hebeieh/autonomous_chess/docs/components_list.csv

Название компонента | Количетсво | Описание
Raspberry Pi Zero 2W | 1 | Микроконтроллер для управления логикой работы
NEMA 17 HS4023 | 2 | Шаговые моторы для движение электромагнита
DRV 8825 | 2 | Драйверы шаговых моторов
Motor Driver Shield | 2 | Плата расширения для подключения моторов и их драйверов
Ведущие шкивы GT2 20Т | 2 | Шкивы крепящиеся к шаговым моторам и ремням gt2
Натяжители зубчатые GT2 20Т | 6 | Детали для натяжения ремня gt2
Натяжители гладкие GT2 | 2 | Детали для натяжения ремня gt2
Ремень GT2 | 2 | Ремень
Электромагнит | 1 | Электромагнит
Линейный подшипник SCS8UU | 4 | Подшипники для движения деталей по стальным стержням с минимальным трением
Стальные стержни 8*500мм | 4 | Стальные стержни
MCP23017 | 1 | Плата расширения I2C
Геркон | 64 | Датчики холла для детекции магнитов
Транзистор IRLZ44N | 1 | Транзистор для управление электромагнитом
Резистор 220Ом | 1 | Резистор
Резистор 1кОм | 1 | Резистор
Неодимовые магниты | 32 | Магниты для крепления под шахматные фигуры
Фиксаторы моторов, стержней и натяжителей |  | Смоделированные и напечатанные на 3д принтере детали
Корпус из дерева | 1 | Вырезанный лазеров из фанеры 6мм корпус
