hebeieh/autonomous_chess/CAD/Сборка_доски_2ver.SLDASM

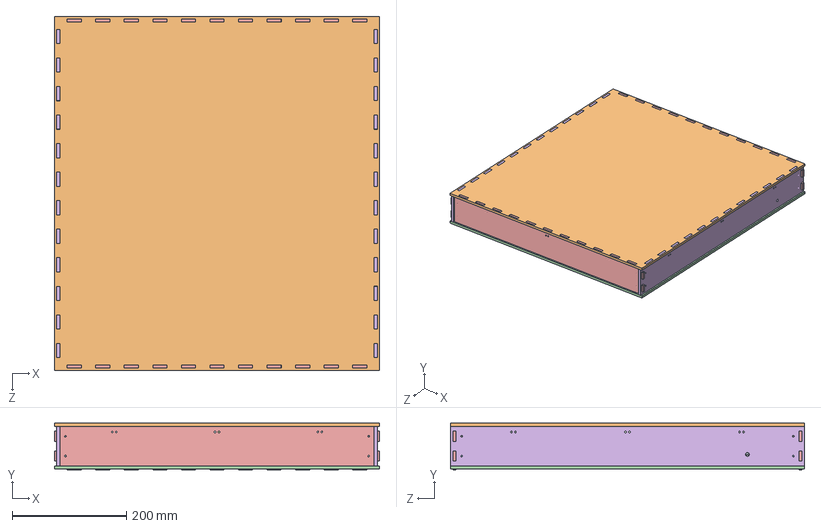
[picture p1: CAD file, 2026-11-10]
CAD/Сборка_доски_2ver.SLDASM
570.1 x 81.7 x 620.0 mm
nema17 x 2
nema17_mount x 2
стержень_8-500 x 4
Натяжитель x 8
Поддержка_натяжителей x 2
Крепление_натяжителей_правое
Крепление_натяжителей_левое
Нижняя_доска
SCS8UU x 4
Коннектор_электрмагнита
Крепление_боковое_левое
Крепление_боковое_правое
Электромагнит
Стена_перед x 2
Стена_бок x 2
Уголок x 8
Уголок_x2 x 12
Верхняя_доска
поддержка_магнита
