hebeieh/autonomous_chess/CAD/На печать/Крепление_боковое_левое.STL

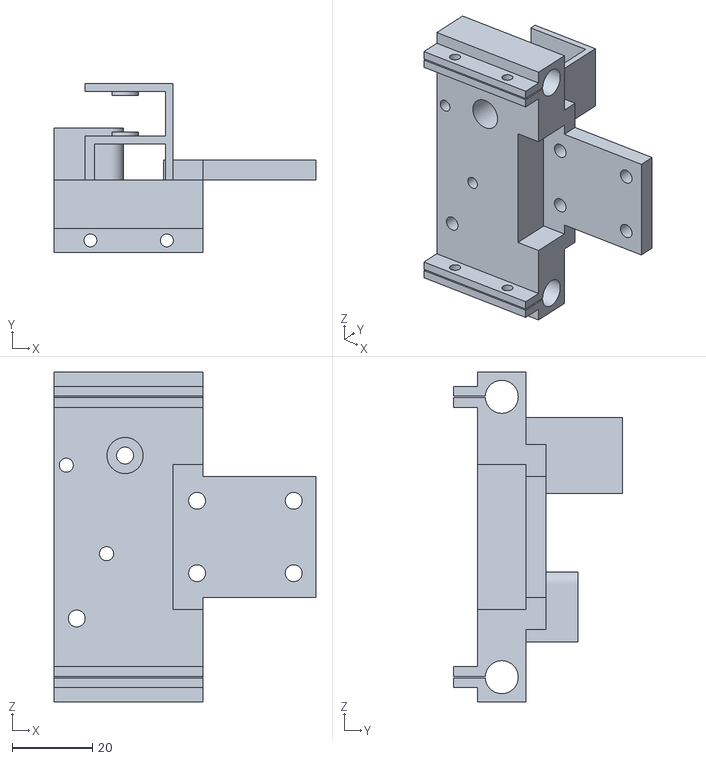
[picture p2: CAD file, 2026-11-10]
CAD/На печать/Крепление_боковое_левое.STL
65.0 x 42.0 x 82.0
