hebeieh/autonomous_chess/CAD/резка/дырка2.dxf

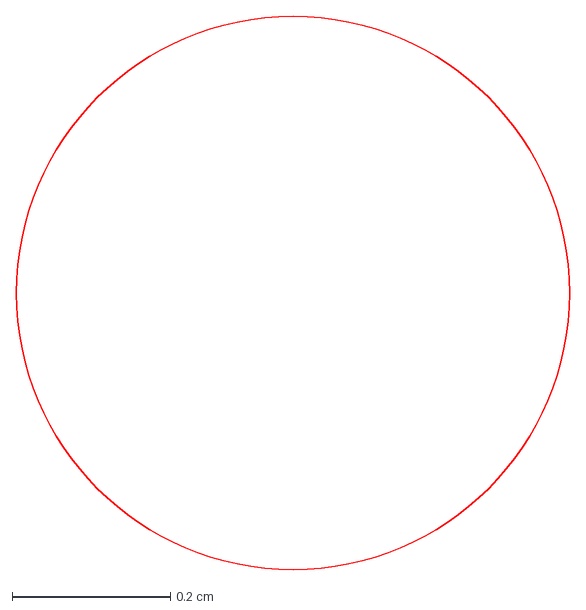
[picture p3: CAD file, 2026-11-10]
CAD/резка/дырка2.dxf
0.7 x 0.7 cm
