hebeieh/autonomous_chess/CAD/Уголок.SLDPRT

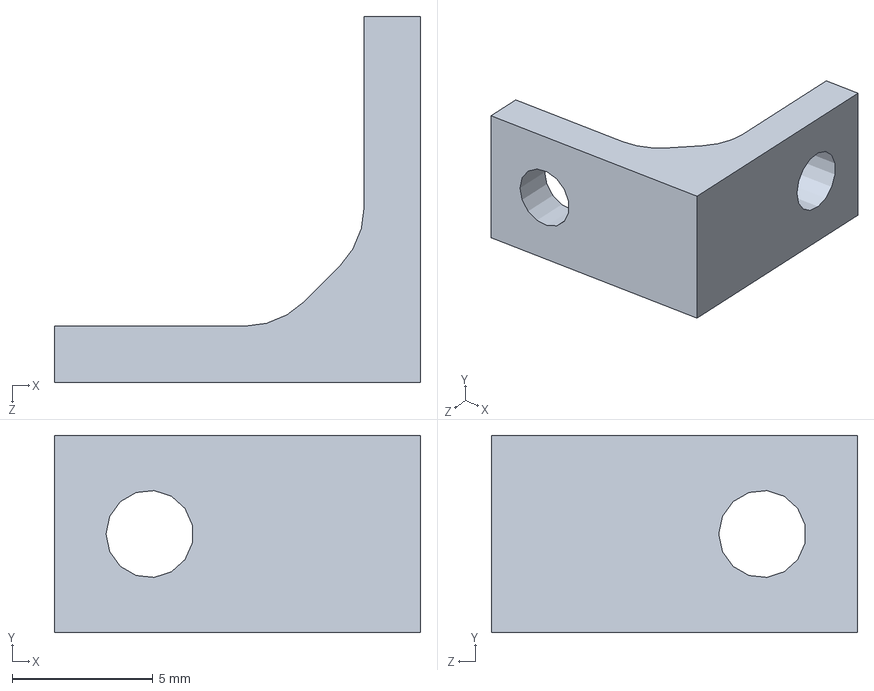
[picture p4: CAD file, 2026-11-10]
CAD/Уголок.SLDPRT
13.0 x 7.00 x 13.0 mm
