hebeieh/autonomous_chess/CAD/Крепление_натяжителей_левое.SLDPRT

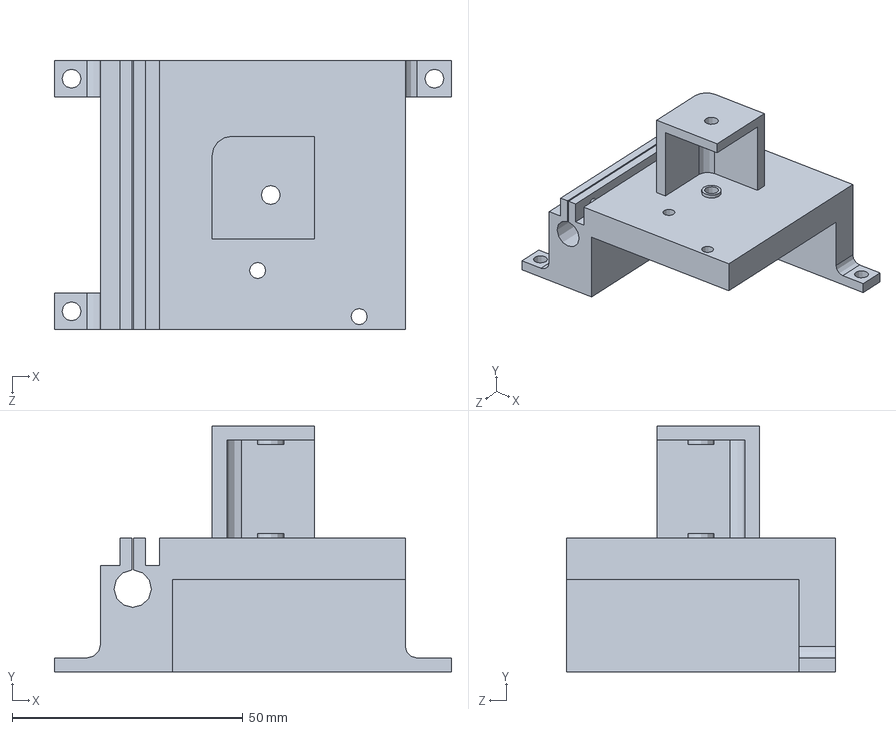
[picture p5: CAD file, 2026-11-10]
CAD/Крепление_натяжителей_левое.SLDPRT
86.0 x 53.2 x 58.3 mm
