hebeieh/autonomous_chess/CAD/На печать/Уголок_x2.STL

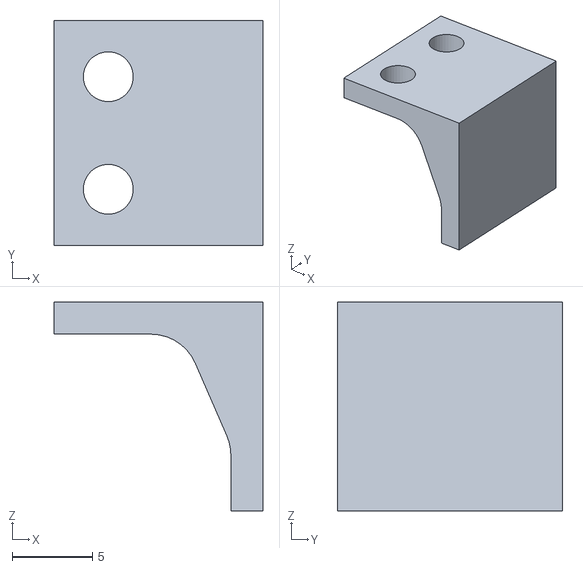
[picture p6: CAD file, 2026-11-10]
CAD/На печать/Уголок_x2.STL
13.0 x 14.0 x 13.0
