hebeieh/autonomous_chess/CAD/резка/поддержка_магнита.DXF

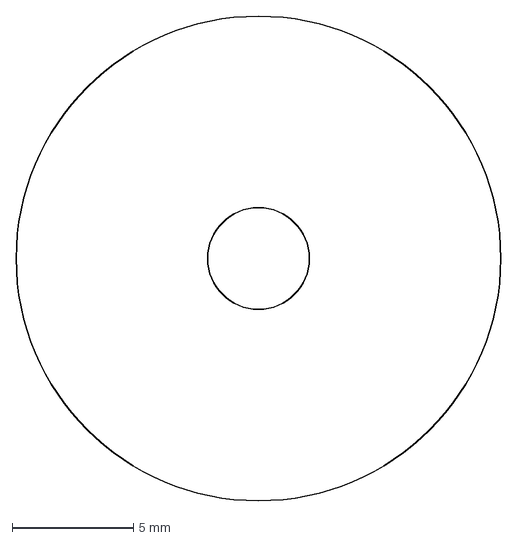
[picture p7: CAD file, 2026-11-10]
CAD/резка/поддержка_магнита.DXF
20.0 x 20.0 mm
