hebeieh/autonomous_chess/CAD/Крепление_боковое_правое.SLDPRT

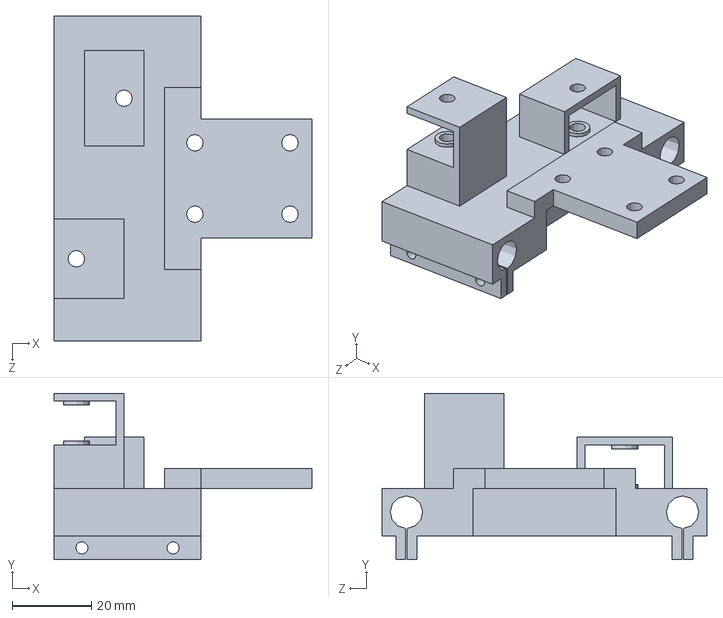
[picture p8: CAD file, 2026-11-10]
CAD/Крепление_боковое_правое.SLDPRT
65.0 x 42.0 x 82.0 mm
