hebeieh/autonomous_chess/CAD/На печать/Крепление_натяжителей_правое.STL

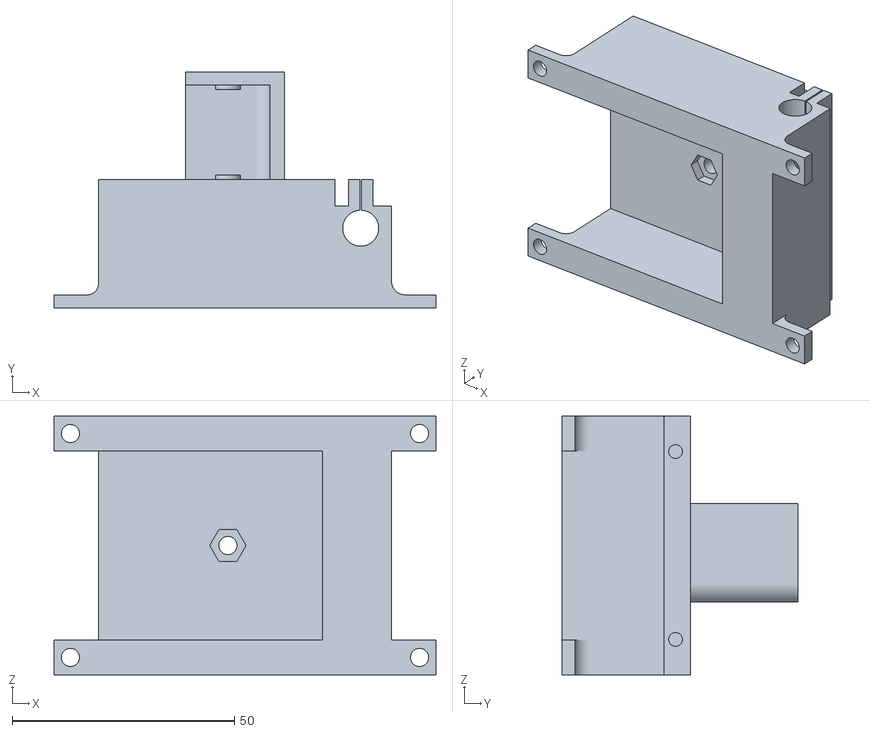
[picture p9: CAD file, 2026-11-10]
CAD/На печать/Крепление_натяжителей_правое.STL
86.0 x 53.2 x 58.3
