hebeieh/autonomous_chess/CAD/Коннектор_электрмагнита.SLDPRT

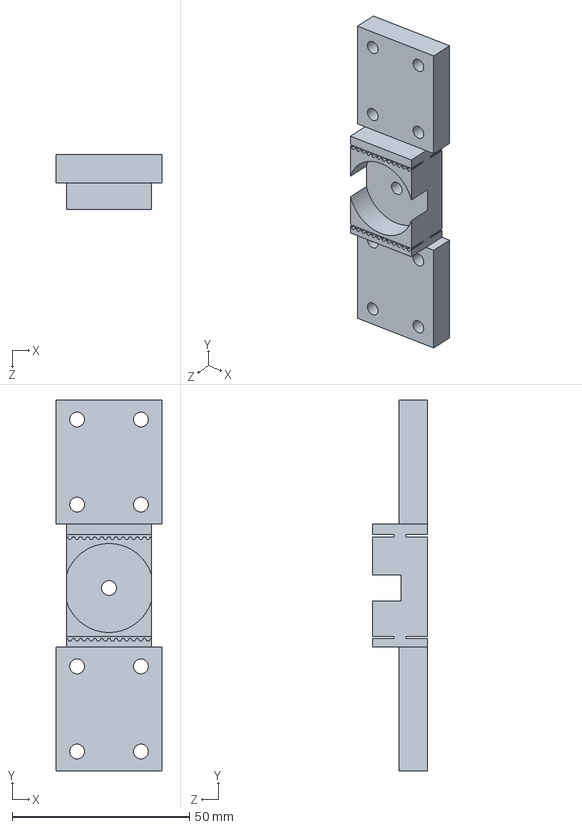
[picture p10: CAD file, 2026-11-10]
CAD/Коннектор_электрмагнита.SLDPRT
30.0 x 104.7 x 15.4 mm
