hebeieh/autonomous_chess/CAD/резка/Стена_перед.DXF

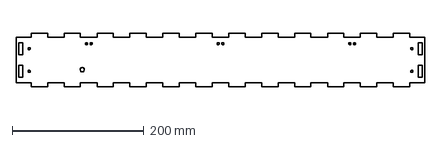
[picture p11: CAD file, 2026-11-10]
CAD/резка/Стена_перед.DXF
620.0 x 80.6 mm
