hebeieh/autonomous_chess/CAD/На печать/Ножки.STL

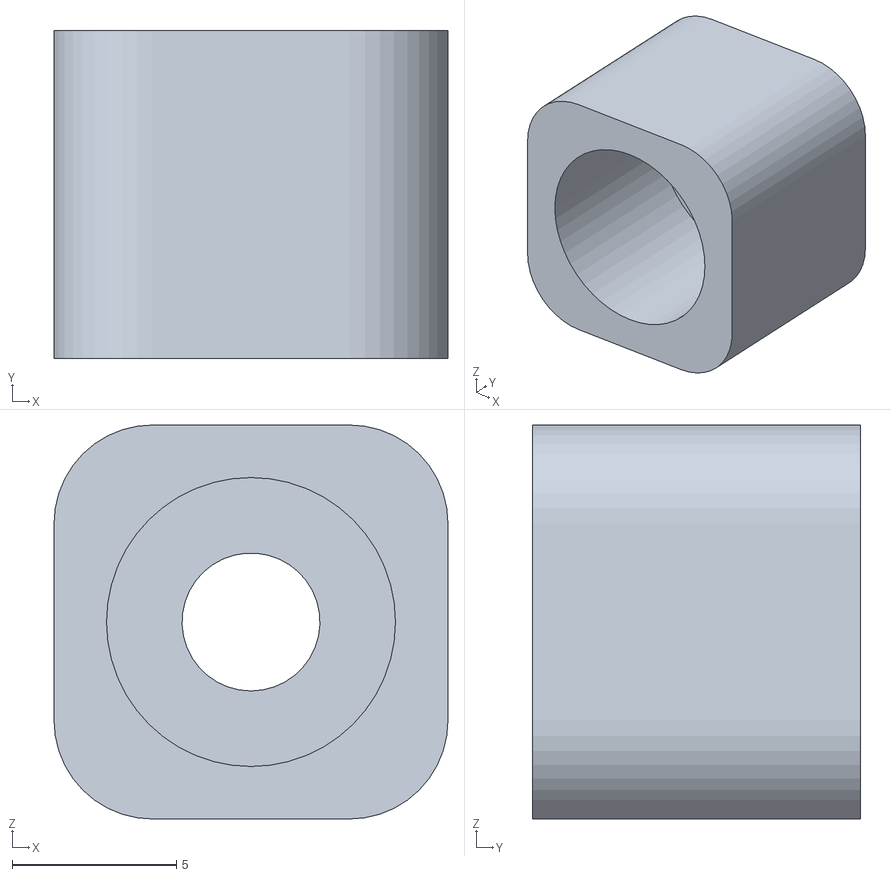
[picture p12: CAD file, 2026-11-10]
CAD/На печать/Ножки.STL
12.0 x 10.0 x 12.0
