hebeieh/autonomous_chess/CAD/резка/Стена_бок.DXF

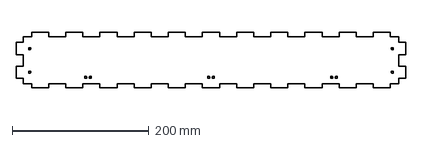
[picture p13: CAD file, 2026-11-10]
CAD/резка/Стена_бок.DXF
570.0 x 81.7 mm
