hebeieh/autonomous_chess/CAD/На печать/поддержка_магнита.STL

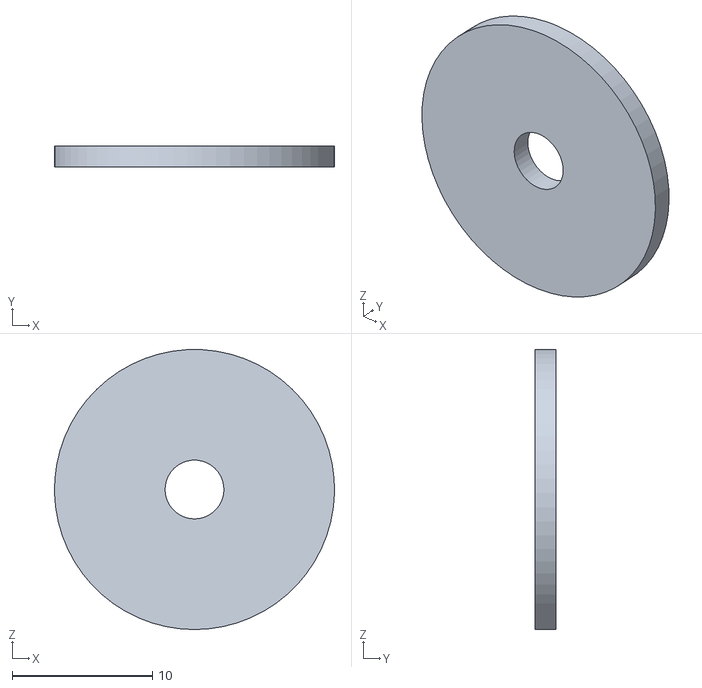
[picture p14: CAD file, 2026-11-10]
CAD/На печать/поддержка_магнита.STL
20.0 x 1.50 x 20.0
