hebeieh/autonomous_chess/CAD/резка/Нижняя_доска.DXF

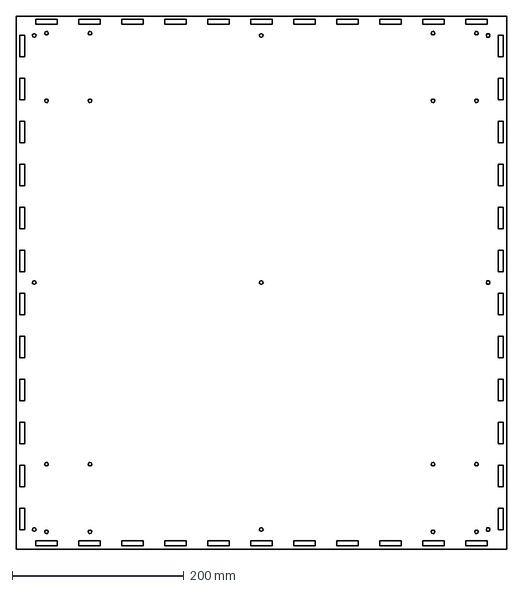
[picture p15: CAD file, 2026-11-10]
CAD/резка/Нижняя_доска.DXF
570.0 x 620.0 mm
