hebeieh/autonomous_chess/CAD/стержень_8-500.SLDPRT

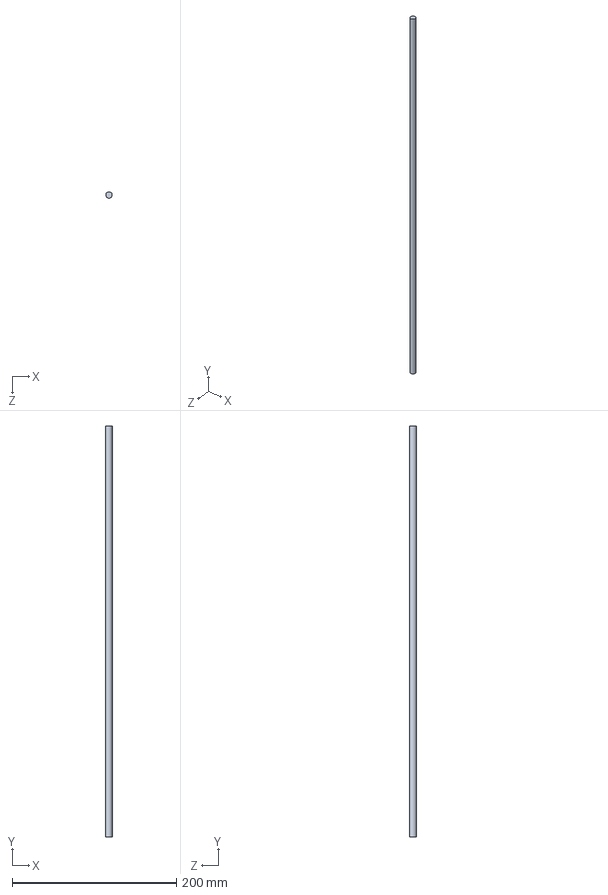
[picture p16: CAD file, 2026-11-10]
CAD/стержень_8-500.SLDPRT
7.94 x 500.0 x 8.00 mm
