hebeieh/autonomous_chess/CAD/На печать/Уголок.STL

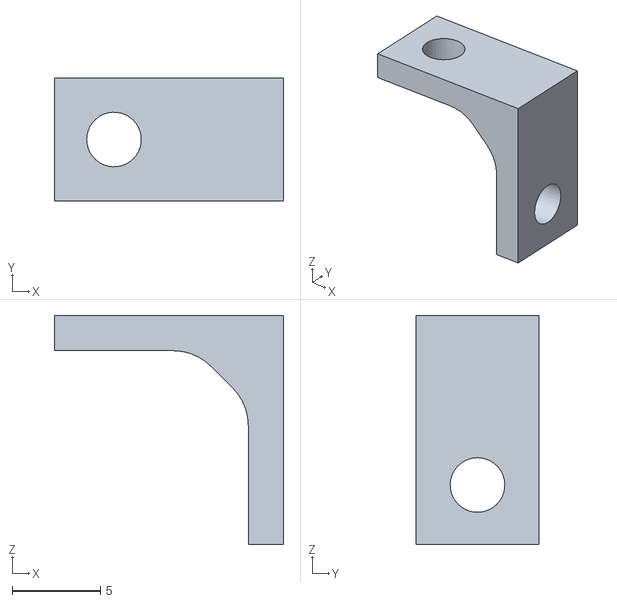
[picture p17: CAD file, 2026-11-10]
CAD/На печать/Уголок.STL
13.0 x 7.00 x 13.0
