hebeieh/autonomous_chess/CAD/На печать/Поддержка_натяжителей.STL

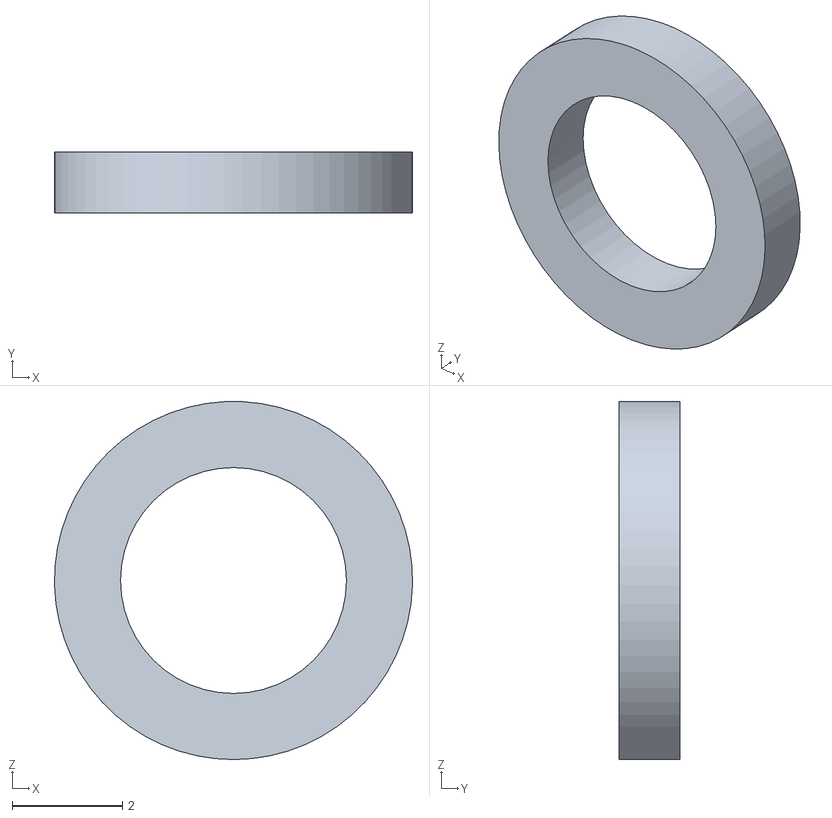
[picture p18: CAD file, 2026-11-10]
CAD/На печать/Поддержка_натяжителей.STL
6.50 x 1.10 x 6.50
