hebeieh/autonomous_chess/CAD/Стена_перед.SLDPRT

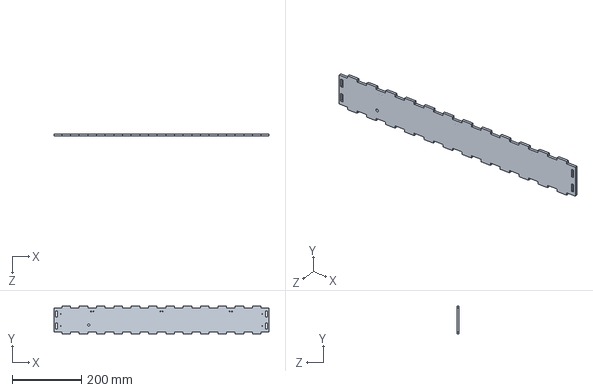
[picture p19: CAD file, 2026-11-10]
CAD/Стена_перед.SLDPRT
620.0 x 80.6 x 5.80 mm
