hebeieh/autonomous_chess/CAD/На печать/nema17_mount.STL

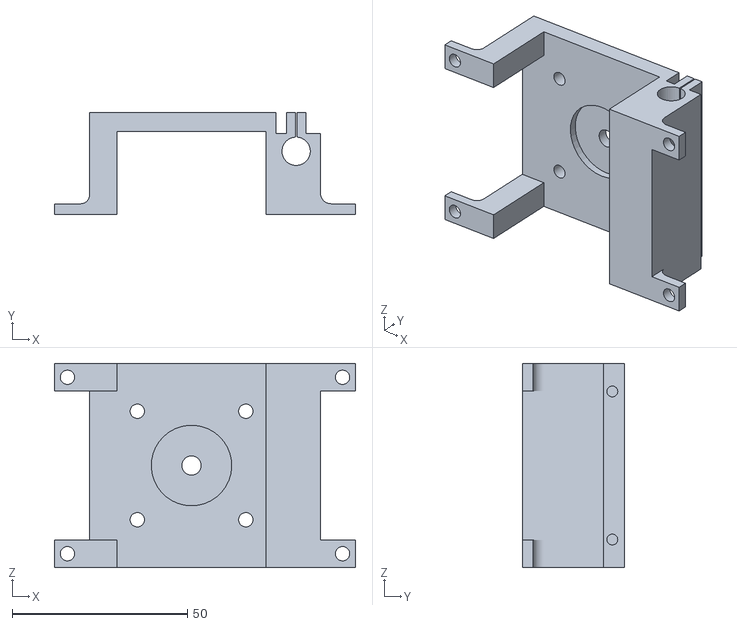
[picture p20: CAD file, 2026-11-10]
CAD/На печать/nema17_mount.STL
86.0 x 29.0 x 58.3
