hebeieh/autonomous_chess/CAD/Электромагнит.SLDPRT

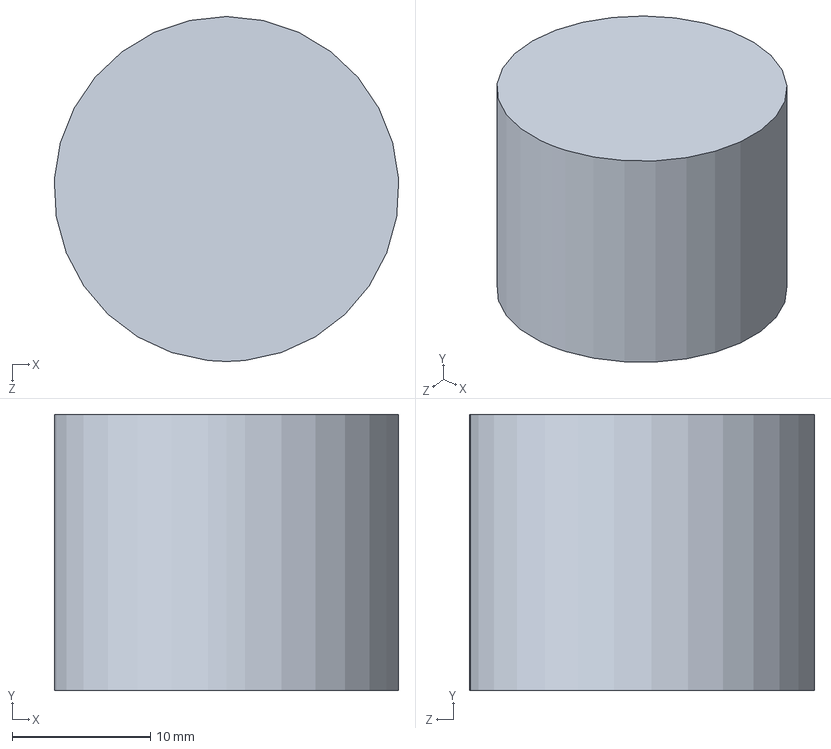
[picture p21: CAD file, 2026-11-10]
CAD/Электромагнит.SLDPRT
25.0 x 20.0 x 25.0 mm
