hebeieh/autonomous_chess/CAD/Нижняя_доска.SLDPRT

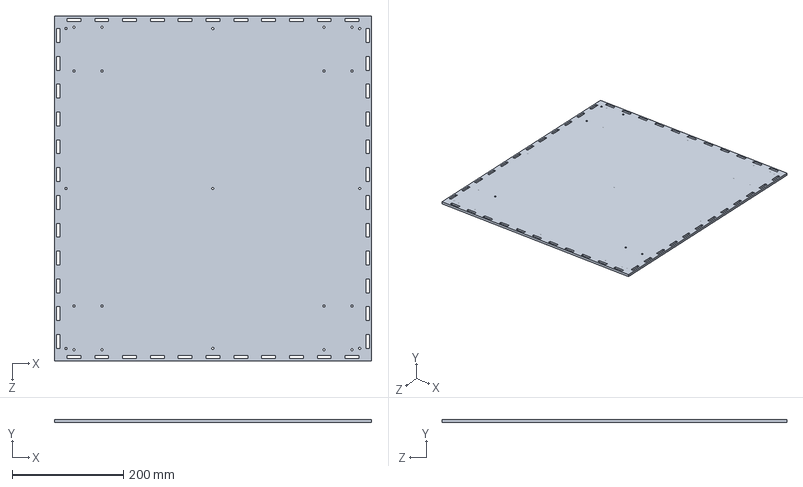
[picture p22: CAD file, 2026-11-10]
CAD/Нижняя_доска.SLDPRT
570.0 x 5.80 x 620.0 mm
