hebeieh/autonomous_chess/CAD/nema17.SLDPRT

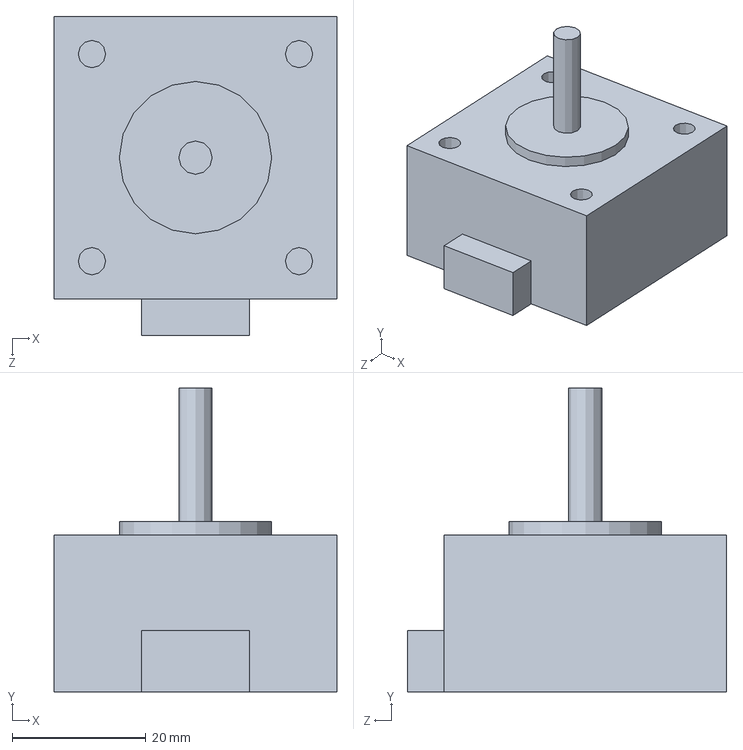
[picture p23: CAD file, 2026-11-10]
CAD/nema17.SLDPRT
42.3 x 45.5 x 47.8 mm
