hebeieh/autonomous_chess/CAD/Поддержка_натяжителей.SLDPRT

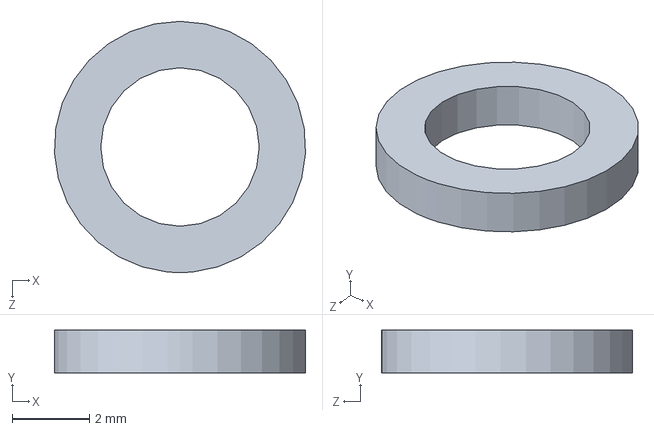
[picture p24: CAD file, 2026-11-10]
CAD/Поддержка_натяжителей.SLDPRT
6.49 x 1.10 x 6.50 mm
