hebeieh/autonomous_chess/CAD/SCS8UU.SLDPRT

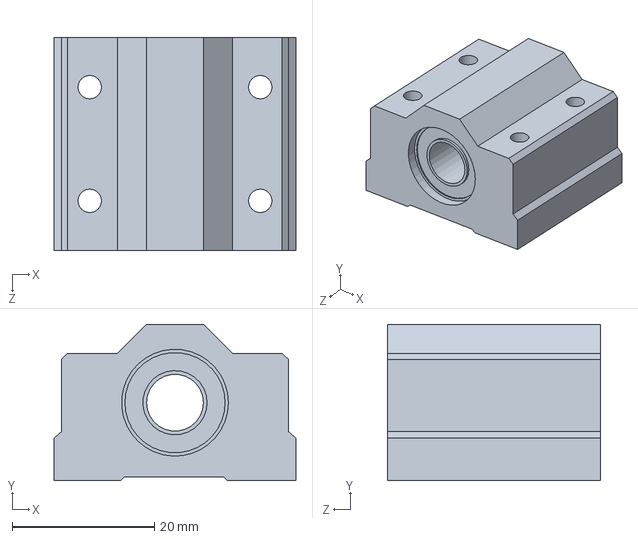
[picture p25: CAD file, 2026-11-10]
CAD/SCS8UU.SLDPRT
34.1 x 22.0 x 30.0 mm
