hebeieh/autonomous_chess/CAD/Стена_бок.SLDPRT

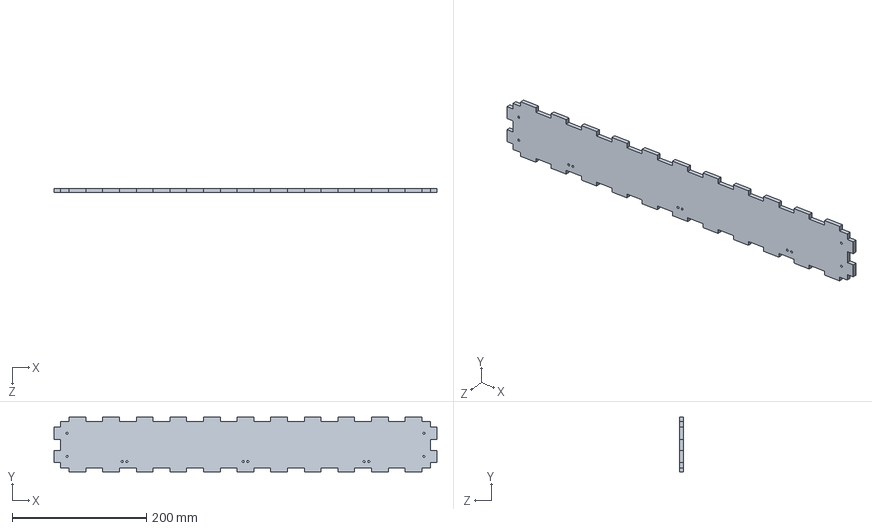
[picture p26: CAD file, 2026-11-10]
CAD/Стена_бок.SLDPRT
570.0 x 81.7 x 5.80 mm
