hebeieh/autonomous_chess/CAD/Натяжитель.SLDPRT

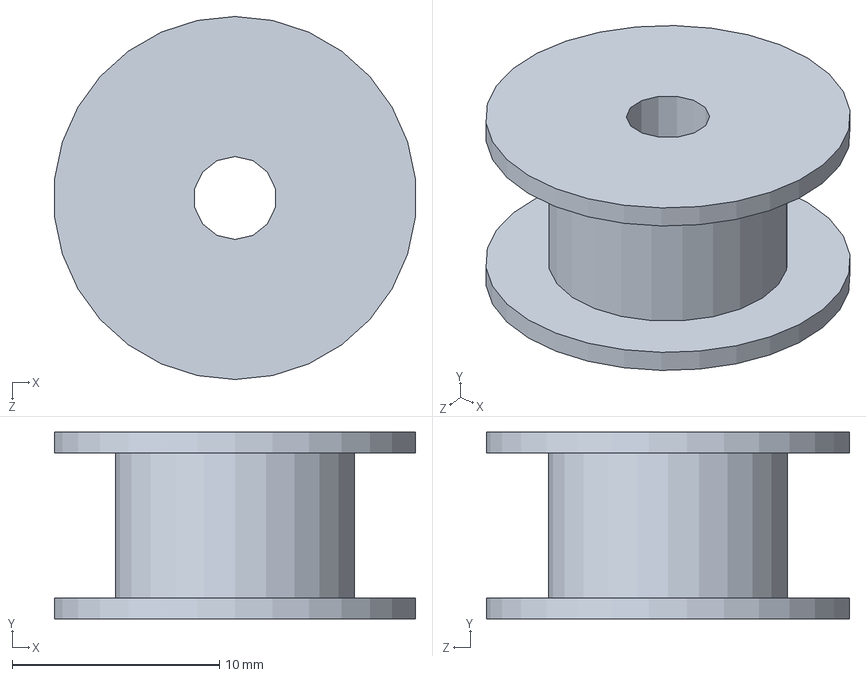
[picture p27: CAD file, 2026-11-10]
CAD/Натяжитель.SLDPRT
17.4 x 9.00 x 17.5 mm
