hebeieh/autonomous_chess/(list of files, cad)

Other CAD files:
CAD/резка/Верхняя_доска.DXF
CAD/На печать/Крепление_боковое_правое.STL
CAD/Уголок_x2.SLDPRT
CAD/На печать/Коннектор_электрмагнита.STL
CAD/Ножки.SLDPRT
CAD/поддержка_магнита.SLDPRT
CAD/На печать/Крепление_натяжителей_левое.STL
CAD/nema17_mount.SLDPRT
CAD/Верхняя_доска.SLDPRT
CAD/Крепление_натяжителей_правое.SLDPRT
CAD/Крепление_боковое_левое.SLDPRT
