hebeieh/autonomous_chess/config.py

"""
Файл конфигурации аппаратной части и параметров поля автономной шахматной доски.
"""

from dataclasses import dataclass


@dataclass
class StepperPinConfig:
    dir_pin: int
    enable_pin: int
    step_pin: int
    invert_dir: bool = False


# ==========================================
# 1. Распиновка GPIO (BCM нумерация выводов)
# ==========================================

# Левый шаговый мотор (Left / Motor A)
# Расположен в нижнем левом углу стола
MOTOR_LEFT = StepperPinConfig(
    dir_pin=27,
    enable_pin=22,
    step_pin=17,
    invert_dir=False,
)

# Правый шаговый мотор (Right / Motor B)
# Расположен в нижнем правом углу стола
MOTOR_RIGHT = StepperPinConfig(
    dir_pin=24,
    enable_pin=25,
    step_pin=23,
    invert_dir=False,
)

# Управление затвором транзистора IRLZ44N для электромагнита
ELECTROMAGNET_PIN = 18

# Логика работы пина Enable для DRV8825:
# 0 (LOW) = драйвер включен (мотор под током)
# 1 (HIGH) = драйвер выключен (обмотки обесточены)
DRV8825_ENABLE_ACTIVE_STATE = 0


# ==========================================
# 2. Кинематика CoreXY и механические параметры
# ==========================================

# Шаговые двигатели NEMA 17 (1.8° на шаг -> 200 шагов/оборот)
STEPS_PER_REV = 200

# Микрошаг драйверов DRV8825
MICROSTEPPING = 16  # Режим 1/16

# Шкив GT2: 20 зубьев, шаг зуба 2.0 мм -> 40.0 мм за один полный оборот
PULLEY_TEETH = 20
BELT_PITCH_MM = 2.0
MM_PER_REV = PULLEY_TEETH * BELT_PITCH_MM  # 40.0 мм

# Количество микрошагов на 1 мм линейного перемещения:
# (200 * 16) / 40.0 = 80.0 шагов/мм
STEPS_PER_MM = (STEPS_PER_REV * MICROSTEPPING) / MM_PER_REV  # 80.0

# Скорость перемещения по умолчанию для тестовых режимов (мм/с)
DEFAULT_TEST_SPEED_MM_S = 25.0

# Минимальная ширина импульса STEP в микросекундах (для DRV8825 мин. 1.9 мкс)
STEP_PULSE_DURATION_US = 5


# ==========================================
# 3. Геометрия шахматного поля и рабочей зоны
# ==========================================

# Размер одной клетки поля (мм)
SQUARE_SIZE_MM = 34.0

# Разметка сетки:
# По горизонтали: 12 клеток (2 кладбище слева + 8 шахматная доска A-H + 2 кладбище справа)
GRID_COLS = 12
# По вертикали: 8 клеток (линии 1-8)
GRID_ROWS = 8

GRID_WIDTH_MM = GRID_COLS * SQUARE_SIZE_MM   # 12 * 34 = 408.0 мм
GRID_HEIGHT_MM = GRID_ROWS * SQUARE_SIZE_MM  # 8 * 34 = 272.0 мм

# Полная зона перемещения каретки механики (мм)
# X: от левого края до правого (0 -> 420 мм)
# Y: от верхнего края до нижнего (0 -> 360 мм)
WORK_AREA_X_MM = 420.0
WORK_AREA_Y_MM = 360.0

# Шахматное поле центрировано внутри зоны перемещения:
# Отступ слева и справа: (420 - 408) / 2 = 6.0 мм
# Отступ сверху и снизу: (360 - 272) / 2 = 44.0 мм
OFFSET_X_MM = (WORK_AREA_X_MM - GRID_WIDTH_MM) / 2.0  # 6.0 мм
OFFSET_Y_MM = (WORK_AREA_Y_MM - GRID_HEIGHT_MM) / 2.0  # 44.0 мм
