hebeieh/autonomous_chess/(commit log)

2026-11-10 Добавлен список материалов и смоделированные файлы
    [SCS8UU.SLDPRT, components_list.csv, nema17.SLDPRT, nema17_mount.SLDPRT, nema17_mount.STL, Верхняя_доска.DXF, Верхняя_доска.SLDPRT, Коннектор_электрмагнита.SLDPRT]
2026-11-10 Добавлен файл для теста моторов и описание
2026-11-10 Правки из-за не той версии os
2026-11-10 Добавлена игра между двумя ботами чтобы проверить работоспособность доски и тесты
